Sasha7b9Work/IntelAvto/README.md

# IntelAvto

** Tools

- Keil uVision 5.42a
- ARM compiler 6.21
