Sasha7b9Work/IntelAvto/doc/РД/Images/readme.txt

Пребразовать *.zip в массив C++ :
    GUI-версия -> Инструменты -> Конвертировать
