Sasha7b9Work/IntelAvto/doc/Комплектация2.docx

пп | Наименование | Кол-во | Примечание
1 | Одноплатный компьютер Orange Pi 5 Plus 8GB | 1
2 | Сетевое зарядное устройство Ugreen CD275 | 1
3 | Кабель Ugreen US316 | 2 | Type-C, 1м
4 | Накопитель SSD KingSpec NE-128-2280 | 1
5 | Карта памяти Kingston Canvas Select Plus microSDXC 64GB | 2
6 | Мышь Logitech M170 Wireless | 1 | беспроводная
7 | Клавиатура SmartBuy One SBK-238AG-K | 1 | беспроводная
8 | Дисплей Zhixianda 12” 1024x768 | 1 | HDMI, сенсорный ёмкостный экран
9 | Cетевой адаптер GST36E12-P1J | 1
10 | Кабель Ugreen HD104 | 2 | HDMI, 0.5м
11 | Карт-ридер Ugreen CM185 | 1
