Sasha7b9Work/IntelAvto/doc/Комплектация.docx

Одноплатный компьютер

1. Orange Pi 5 Plus 4/8/16 GB RAM.

Пример - https://clck.ru/3JQ5TD

2. Cетевое зарядное устройство 220/5В, разъём Type-C, ток не менее 4А.

Пример - https://clck.ru/3JQ5gP

3. Кабель USB с разъёмами Type-C.

Пример - https://clck.ru/3JQ5wi

4. Твердотельный накопитель SSD 128 GB, форм-фактор M.2, размер 2280.

Пример - https://clck.ru/3JQE7P

Дислей

1. Дисплей 12 дюймов, разрешение 1024х768, интерфейс HDMI, ёмкостный сенсорный экран.

http://www.cnzhixianda.com/en/product_547073.html

Производитель/поставщик - Zhixianda - http://www.cnzhixianda.com/en/

Примеры:

https://clck.ru/3JQBTy

https://clck.ru/3JQBbk

https://clck.ru/3JQBnd

https://clck.ru/3JQByH

2. Сетевой адаптер 12В, 3А GST36E12-P1J

Пример - https://clck.ru/3JQQ2D

3. Кабель HDMI-MicroHDMI, 1м, производитель – Ugreen

https://clck.ru/3JQSKZ
