Sasha7b9Work/IntelAvto/doc/Hardware/IT6500/МНИПИ_IT6523C-испытания/Осциллограммы/006-DIN40839-12-T9-CVHI.png

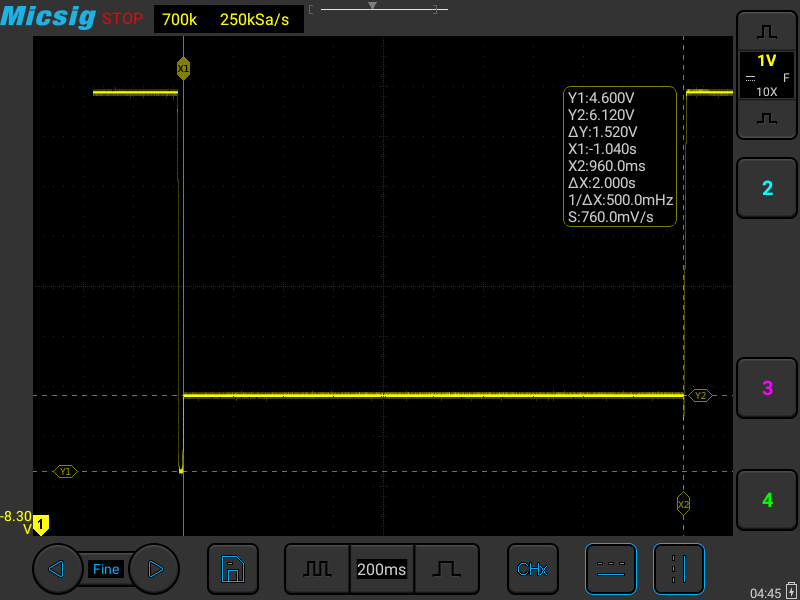
doc/Hardware/IT6500/МНИПИ_IT6523C-испытания/Осциллограммы/006-DIN40839-12-T9-CVHI.png
