Sasha7b9Work/IntelAvto/doc/Hardware/IT6500/МНИПИ_IT6523C-испытания/Осциллограммы/006-LDA-12-14V-80V.png

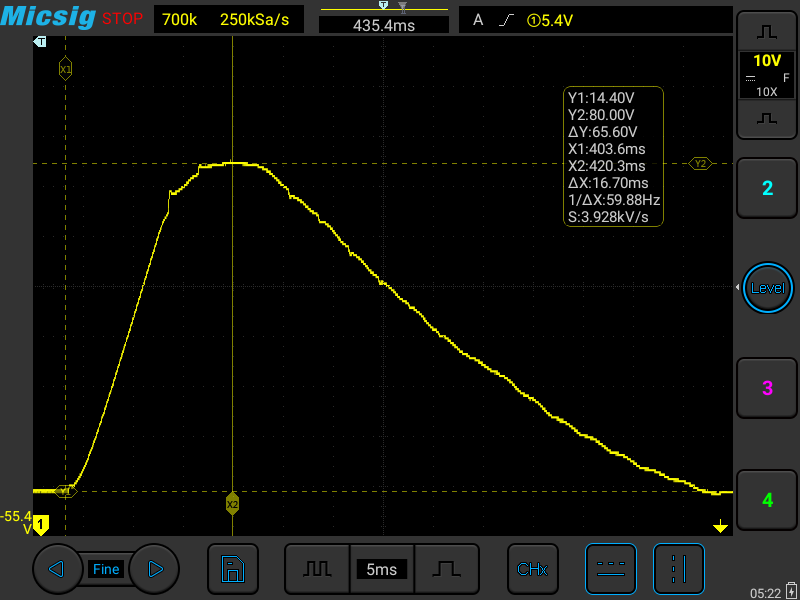
doc/Hardware/IT6500/МНИПИ_IT6523C-испытания/Осциллограммы/006-LDA-12-14V-80V.png
