Sasha7b9Work/IntelAvto/doc/Hardware/IT6500/МНИПИ_IT6523C-испытания/Осциллограммы/006-LDA-12-TD1479.png

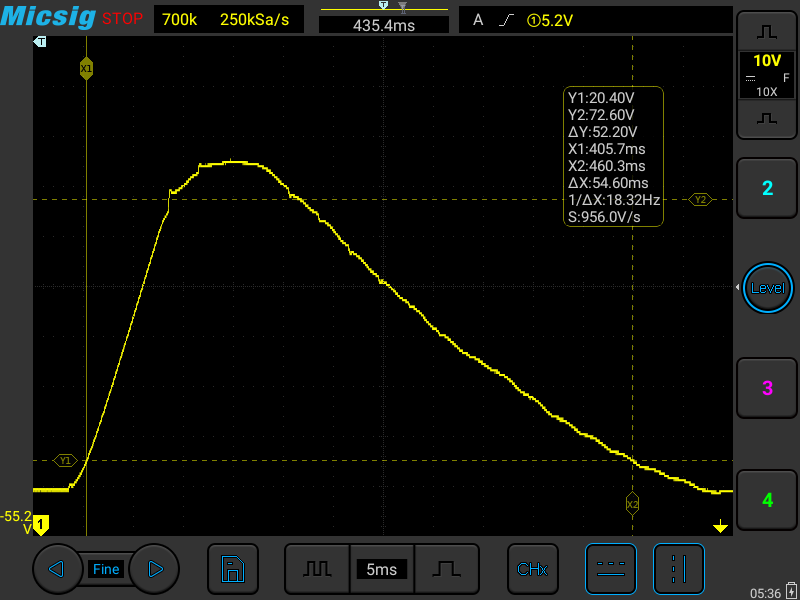
doc/Hardware/IT6500/МНИПИ_IT6523C-испытания/Осциллограммы/006-LDA-12-TD1479.png
