Sasha7b9Work/IntelAvto/doc/Hardware/IT6500/МНИПИ_IT6523C-испытания/Фото/IMG_4344.JPG

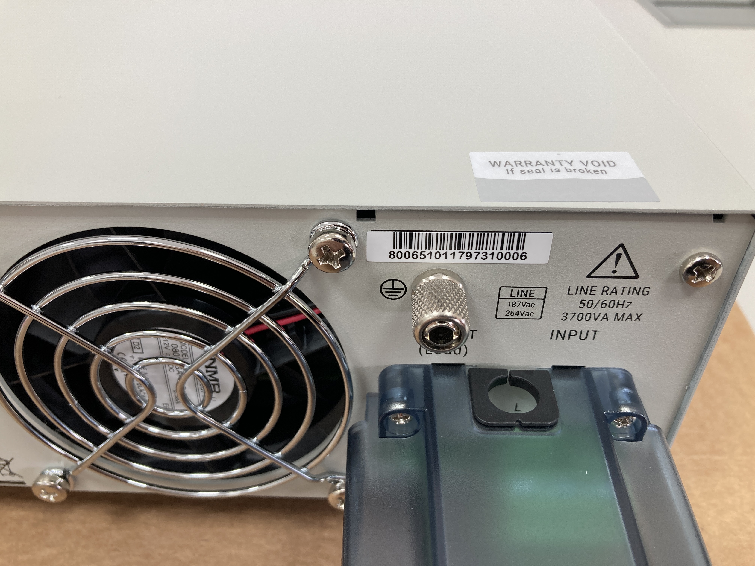
doc/Hardware/IT6500/МНИПИ_IT6523C-испытания/Фото/IMG_4344.JPG
