Sasha7b9Work/IntelAvto/doc/РД/Images/display.png

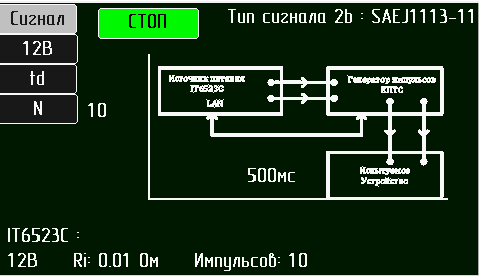
doc/РД/Images/display.png
