Sasha7b9Work/IntelAvto/doc/РД/Images/Signal1/Signal1.png

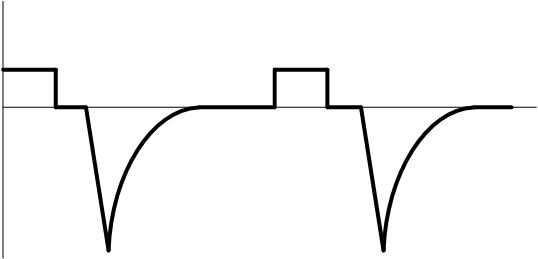
doc/РД/Images/Signal1/Signal1.png
