Sasha7b9Work/IntelAvto/doc/РД/Images/Signal2a/Signal2a.png

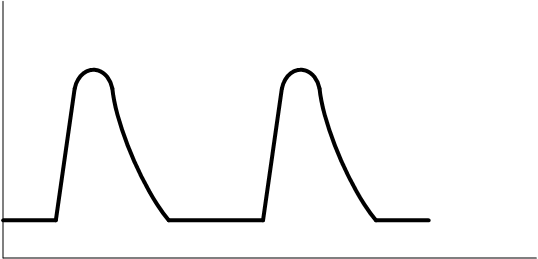
doc/РД/Images/Signal2a/Signal2a.png
