Sasha7b9Work/IntelAvto/doc/РД/Images/Signal2b/Signal2b.png

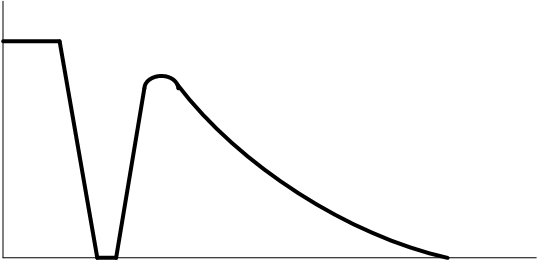
doc/РД/Images/Signal2b/Signal2b.png
