Sasha7b9Work/IntelAvto/doc/РД/Images/Signal3a/Signal3a.png

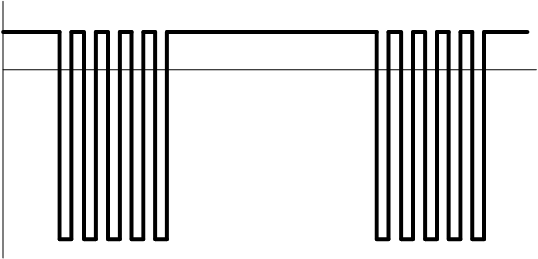
doc/РД/Images/Signal3a/Signal3a.png
