Sasha7b9Work/IntelAvto/doc/РД/Images/Signal3b/Signal3b.png

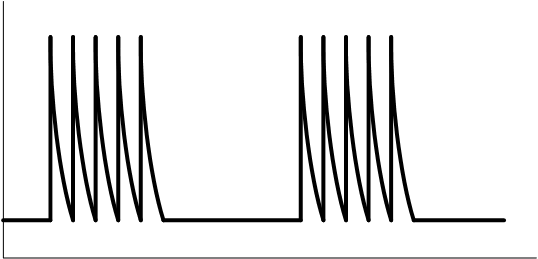
doc/РД/Images/Signal3b/Signal3b.png
