Sasha7b9Work/IntelAvto/doc/РД/Images/Signal4/Signal4.png

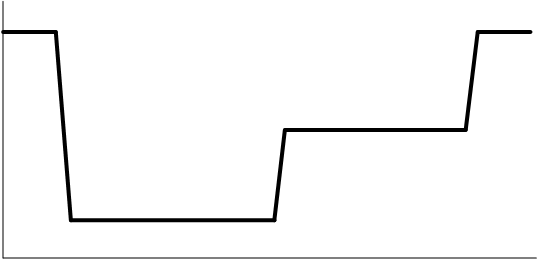
doc/РД/Images/Signal4/Signal4.png
