Sasha7b9Work/IntelAvto/doc/РД/Images/Signal5a/Signal5a.png

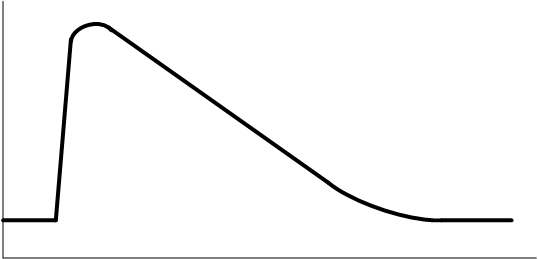
doc/РД/Images/Signal5a/Signal5a.png
