Sasha7b9Work/IntelAvto/doc/РД/schematic/SWD panel.jpg

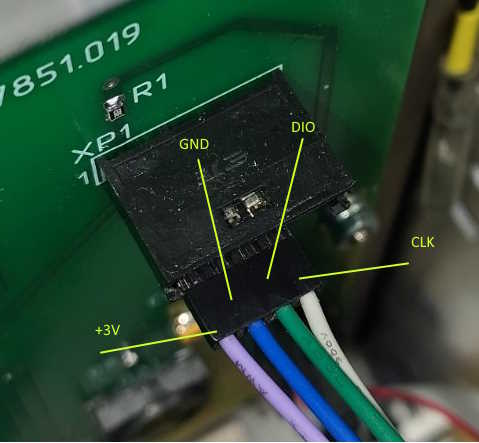
doc/РД/schematic/SWD panel.jpg
