Sasha7b9Work/IntelAvto/sources/Device/src/Hardware/HAL/HAL_PINS.cpp

// 2024/02/01 16:42:26 (c) Aleksandr Shevchenko e-mail : Sasha7b9@tut.by
#include "defines.h"
#include "Hardware/HAL/HAL.h"
#include "Hardware/HAL/HAL_PINS.h"
#include "Hardware/Timer.h"
#include <stm32f4xx_hal.h>


PinOut pin_A0_RG(GPIOG, GPIO_PIN_8);
PinOut pin_A1_RG(GPIOG, GPIO_PIN_7);
PinOut pin_A2_RG(GPIOG, GPIO_PIN_6);
PinOut pin_A3_RG(GPIOG, GPIO_PIN_5);
PinOut pin_CLK_RG(GPIOD, GPIO_PIN_11);
PinOut pin_DAT_RG(GPIOD, GPIO_PIN_13);
PinOut pin_WR_RG(GPIOD, GPIO_PIN_12);
PinOut pin_A12(GPIOE, GPIO_PIN_13);
PinOut pin_2A(GPIOE, GPIO_PIN_12);
PinOut pin_3AB(GPIOE, GPIO_PIN_11);
PinOut pin_K4_COM(GPIOC, GPIO_PIN_3);
PinOut pin_K5_COM(GPIOC, GPIO_PIN_2);
PinOut pin_K6_COM(GPIOC, GPIO_PIN_1);
PinOut pin_K7_COM(GPIOC, GPIO_PIN_0);
PinOut pin_K3_COM(GPIOF, GPIO_PIN_10);

PinOut pin_K1_FOR(GPIOF, GPIO_PIN_1);

PinOut pin_DAC_SCLK_R(GPIOA, GPIO_PIN_12);
PinOut pin_DAC_DAT_R(GPIOA, GPIO_PIN_11);
PinOut pin_DAC_ENB_HV(GPIOA, GPIO_PIN_8);
PinOut pin_DAC_CS(GPIOA, GPIO_PIN_10);

PinOut pin_ON_OFF(GPIOD, GPIO_PIN_9);
PinOut pin_START(GPIOD, GPIO_PIN_8);            // 77
PinOut pin_STOP(GPIOB, GPIO_PIN_15);
PinOut pin_NPULES0(GPIOG, GPIO_PIN_0);
PinOut pin_NPULSE1(GPIOF, GPIO_PIN_15);
PinOut pin_NPULSE2(GPIOF, GPIO_PIN_14);


void HAL_PINS::Init()
{
    pin_A0_RG.Init();
    pin_A1_RG.Init();
    pin_A2_RG.Init();
    pin_A3_RG.Init();
    pin_CLK_RG.Init();
    pin_DAT_RG.Init();
    pin_WR_RG.Init();

    pin_ON_OFF.Init();
    pin_START.Init();
    pin_STOP.Init();

    pin_A12.Init();
    pin_2A.Init();
    pin_3AB.Init();
    pin_K3_COM.Init();
    pin_K5_COM.Init();
    pin_K6_COM.Init();
    pin_K7_COM.Init();

    pin_K1_FOR.Init();

    pin_DAC_SCLK_R.Init();
    pin_DAC_DAT_R.Init();
    pin_DAC_ENB_HV.Init();
    pin_DAC_CS.Init();
    pin_DAC_CS.ToHi();

    pin_NPULES0.Init();
    pin_NPULES0.ToHi();
    pin_NPULSE1.Init();
    pin_NPULSE1.ToHi();
    pin_NPULSE2.Init();
    pin_NPULSE2.ToLow();
}


void PinOut::ToHi()
{
    GPIO_TypeDef *gpio = (GPIO_TypeDef *)port;

    HAL_GPIO_WritePin(gpio, pin, GPIO_PIN_SET);
}


void PinOut::ToHi(uint timeUS)
{
    ToHi();

    HAL_TIM::DelayUS(timeUS);

    ToLow();
}


void PinOut::ToLow()
{
    GPIO_TypeDef *gpio = (GPIO_TypeDef *)port;

    HAL_GPIO_WritePin(gpio, pin, GPIO_PIN_RESET);
}


void PinOut::ToState(bool state)
{
    state ? ToHi() : ToLow();
}


bool PinIn::IsLow() const
{
    return HAL_GPIO_ReadPin((GPIO_TypeDef *)port, pin) == GPIO_PIN_RESET;
}


bool PinIn::IsHi() const
{
    return !IsLow();
}


void Pin::Init()
{
    if (mode == PinMode::OUTPUT)
    {
        GPIO_InitTypeDef is =
        {
            pin,
            GPIO_MODE_OUTPUT_PP,
            GPIO_PULLUP
        };
        HAL_GPIO_Init((GPIO_TypeDef *)port, &is);

        HAL_GPIO_WritePin((GPIO_TypeDef *)port, pin, GPIO_PIN_RESET);
    }
    else if (mode == PinMode::INPUT)
    {
        GPIO_InitTypeDef is =
        {
            pin,
            GPIO_MODE_INPUT,
            GPIO_PULLUP
        };

        HAL_GPIO_Init((GPIO_TypeDef *)port, &is);
    }
}
