Sasha7b9Work/IntelAvto/sources/common/Display/Colors_.h

// (c) Aleksandr Shevchenko e-mail : Sasha7b9@tut.by
#pragma once
#include "defines.h"


struct Color
{
    static Color FILL;              // Цвет белых надписей
    static Color BACK;              // Цвет фона
    static Color MENU_UNSELECT;     // Фон невыделенного итема
    static Color MENU_SELECT;       // Фон выделенного итема
    static Color RED;               // Красный компонент для настройки
    static Color GREEN;             // Зелёный компонент для настройки
    static Color BLUE;              // Синий компонент для настройки
    static Color WHITE;             // Белый
    static Color BLACK;             // Чёрный фон
    static Color GRAY;
    static Color YELLOW;
    static Color GRAY_75;

    static const int COUNT = 255;

    explicit Color(uint8 i) : index(i) {}

    void SetAsCurrent() const;
    static Color GetCurrent();

    uint8 Index() const { return index;  }

    void SetValue(uint value) const { Value() = value; }
    void SetValue(uint8 red, uint8 green, uint8 blue) const { Value() = Make(red, green, blue); }

    // Ссылка на значение
    uint &Value() const;

    static uint Make(uint8 r, uint8 g, uint8 b) { return ((uint)((b) | ((g) << 8) | ((r) << 16))); }

    uint8 GetRED() const;
    uint8 GetGREEN() const;
    uint8 GetBLUE() const;

private:

    uint8 index;
};


struct ColorScheme
{
    static const int COUNT = 3;
    uint colors[Color::COUNT];

    static ColorScheme &Current();
};


namespace ColorTimer
{
    void Reset();
    bool IsMain();
}


#ifdef GUI

    #define MAKE_COLOR(r, g, b)     ((uint)((b) | ((g) << 8) | ((r) << 16)))

    #define RED_FROM_COLOR(color)   ((uint8)(((color) >> 16) & 0xFF))
    #define GREEN_FROM_COLOR(color) ((uint8)(((color) >> 8) & 0xFF))
    #define BLUE_FROM_COLOR(color)  ((uint8)((color) & 0xFF))
#else

    #define RED_FROM_COLOR(color)   ((uint8)(((color) >> 16) & 0xFF))
    #define GREEN_FROM_COLOR(color) ((uint8)(((color) >> 8) & 0xFF))
    #define BLUE_FROM_COLOR(color)  ((uint8)((color) & 0xFF))

#endif
