Sasha7b9Work/IntelAvto/sources/common/FlashDrive/FileManager.h

// 2025/02/03 14:33:10 (c) Aleksandr Shevchenko e-mail : Sasha7b9@tut.by
#pragma once 


namespace FileManager
{
    // Вызывается один раз при обнаружении новой флешки
    void Init();

    // Нарисовать файловый менеджер
    void Draw();

    void PressSB_LevelUp();

    void PressSB_LevelDown();

    void RotateRegSet(int angle);

    bool GetNameForNewFile(char name[255]);

    void PressSB_Tab();
};
