Sasha7b9Work/IntelAvto/sources/Device/src/Generator/MCP4811.h

// 2024/02/02 00:22:10 (c) Aleksandr Shevchenko e-mail : Sasha7b9@tut.by
#pragma once


struct Value;


// Определяет размах выходного напряжения
namespace MCP4811
{
    void SetVoltage(const Value &);

    void Disable();
}
