Sasha7b9Work/IntelAvto/sources/Device/src/Connector/Device/Interface_d.h

// (c) Aleksandr Shevchenko e-mail : Sasha7b9@tut.by
#pragma once
#include "Utils/Queue_.h"


namespace DInterface
{
    void Update();

    // Возвращает ссылку на очередь сообщений, ожидающих отправки
    Queue &GetOutbox();
};
