Sasha7b9Work/IntelAvto/sources/Device/src/Generator/MAX532.h

// 2024/02/04 18:33:29 (c) Aleksandr Shevchenko e-mail : Sasha7b9@tut.by
#pragma once


struct Value;


// Источник питания истокового повторителя
namespace MAX532
{
    void SetVoltage(const Value &);

    void Test();
}
