Sasha7b9Work/IntelAvto/sources/common/Connector/Transceiver_.h

// (c) Aleksandr Shevchenko e-mail : Sasha7b9@tut.by
#pragma once
#include "Connector/Messages_.h"


/*

    Передача должна производиться так.

*/


namespace Transceiver
{
    void Transmit(BaseMessage *message);
};
