Sasha7b9Work/IntelAvto/sources/common/Display/Symbols_.h

// (c) Aleksandr Shevchenko e-mail : Sasha7b9@tut.by
#pragma once


#define SYMBOL_AC                  0x80
#define SYMBOL_AC_IN_QUOTES       "\x80"
#define SYMBOL_DC                  0x81
#define SYMBOL_DC_IN_QUOTES       "\x81"
#define SYMBOL_FRONT               0x82     // Фронт
#define SYMBOL_FRONT_IN_QUOTES    "\x82"
#define SYMBOL_RISE                0x83     // Срез
#define SYMBOL_RISE_IN_QUOTES     "\x83"


struct UGO
{
    static pchar OVERLAPPED;    // Индикация переполнения
    static pchar EMPTY_VALUE;   // Выводится, когда значение ещё не получено после засылки значения
    static pchar DivNULL;       // Индикация деления на ноль
};
