Sasha7b9Work/IntelAvto/sources/VS/Panel/src/GUI/ConsoleSCPI.h

// 2023/09/08 21:00:21 (c) Aleksandr Shevchenko e-mail : Sasha7b9@tut.by
#pragma once
#pragma warning(push, 0)
#include <wx/frame.h>
#include <wx/timer.h>
#pragma warning(pop)


class ConsoleSCPI : public wxFrame
{
public:

    static pString DIRECT_PROMT;
    static pString REVERSE_PROMT;

    static ConsoleSCPI *Self();
    virtual ~ConsoleSCPI();

    void SwitchVisibility();

    void AddLine(const wxString &);
    void AddText(const wxString &);
    void AddTextPromt(const wxString &);

    void StartTest();
    void StopTest();

private:
    ConsoleSCPI(wxFrame *parent);

    void OnSize(wxSizeEvent &);
    void OnTextEnter(wxCommandEvent &);
    void OnTextControlKeyDown(wxKeyEvent &);
    void OnClose(wxCloseEvent &);

    wxTimer timerComPort;
    wxTimer timerTest;
    void OnTimerComPort(wxTimerEvent &);
    void OnTimerTest(wxTimerEvent &);

    void SendToSCPI(const char *);

    class History
    {
    public:
        void Add(const wxString &text);
        wxString Next();
        wxString Prev();

    private:
        std::vector<wxString> history;
        uint position = 1;
    };

    History history;
};
