Sasha7b9Work/IntelAvto/(commit log)

2023-09-08 GUI-версия компилируется, но не работает
2023-09-08 Работает GUI-версия
2023-09-11 Запускается на макете частотомера
2023-11-02 Работает на макете
2023-11-02 Исправлены баги отображения на приборе
    [Display_stm.cpp]
2023-11-02 сигнал 3a
2023-11-02 сигнал 3b
2023-11-02 сигнал 4
2023-11-02 Начало сигнала 5а
2023-12-13 Процессор изменили на 429. Не компилируется
2023-12-14 Компилируется Panel
2023-12-14 vs_keil компилируется
2023-12-14 Всё компилируется
2023-12-14 Готово к пробной записи
2023-12-14 Запускается, но где-то висит
2023-12-14 оптимизинованы засылки в дисплей
2023-12-14 Рвботает
2023-12-18 keil компилируется без предупреждений после перехода на C++ 6
2023-12-18 keil часть предупреждений удалены
2023-12-18 Компилируется release-версия Panel keil
2023-12-18 Компилируются release- и debug-версии Panel keil
2023-12-18 Компилируется loader - release
2023-12-18 Всё keil компилируется без предупреждений
2023-12-18 Loader отделён от Panel
2023-12-19 Компилируется win-версия
2023-12-19 Не компилируется
2023-12-20 Вылет при запуске win-версии
2023-12-20 Восстановлена работоспособность win
2024-01-18 Не работает
2024-01-25 Восстановлена компилируемость vs_keil-версии
2024-02-01 Исправлен баг с вылетом на последнем сигнале
2024-02-01 v2 Напряжение вводится в вольтах, время - в миллисекундах
2024-02-01 v3 Начинаем Device в Panel
2024-02-01 v4 Заготовка для информации о генерации импульсов
2024-02-01 Добавлены файлы от Г6-49 для Device - там такой же процессор и интерфейс SPI для сообщения
2024-02-01 Не компилируется Device
2024-02-01 Компилиуется Device. Без функционала
2024-02-04 реле платы коммутации установленаы
2024-02-05 В панель докинуты файлы для SPI с платой управления
2024-02-05 Инициализирован SPI на стороне панели
2024-02-05 Добавлен файл SPI в Device
2024-02-08 С оптимизацией не работает. Наверное, дело в скорости засылки
2024-02-08 Частично работает клавиатура не вводится значение и не работает кнопка ручки
2024-02-08 Работает на оптимизации О1
2024-02-08 Работает на оптимизации fast
2024-02-08 Оптимизация дисплея закончена
2024-02-08 Работает управление кроме кнопки ручки
2024-02-08 Настроены отладчики
2024-02-08 Работает чипселект на SPI
2024-02-08 Пошёл сигнал на устройство
2024-02-08 Плата принимает переданную информацию
2024-02-08 В теории команда должна доходить до прибора
2024-02-08 Идёт команда Start2A на отработку
2024-02-08 устройство принимает, но только в отладке
2024-02-08 Приём в Device сделан программно
2024-02-08 Не работает программный SPI
2024-02-08 Теоретически реализовван программный SPI@
2024-02-09 Работает программный SPI в обе стороны
2024-02-09 Без отладчика не работае
2024-02-12 Уменьшено время сообщения между платами до 1 мс
2024-02-12 Работает передача
2024-02-12 Уменьшена длительность передачи
2024-02-12 По нажатию кнопки ПУСК идёт команда
2024-02-12 Не работает установка периода
2024-02-12 Не работает установка период
2024-02-12 Засылается период сигнала 2А
2024-02-13 Начинаем переходить на другое представление единиц измерений
2024-02-14 Работает ввод временных параметров
2024-02-14 Установка на экране параметров первого сигнала
2024-02-15 не работают сигналы
2024-02-15 Кажется, работает
2024-02-20 Тест MAX532
2024-02-27 Первая версия засылки напряжения
2024-02-27 Вторая версия засылки напряжения
2024-02-27 Подогнаны пределы MAX532@
2024-08-21 Без задержки не работал чипселект. Оставил пометку
2025-01-15 Переделана клавиатура под текущую, но вообще не работает
2025-01-15 Отмотали на две версии назад
2025-01-15 Возврат на keil 5.37
2025-01-15 Работает на 5.37
2025-01-15 Работает 5.39Э
2025-01-15 Не работаеь на 5.40
2025-01-16 Переход на Keil 5.39
2025-01-16 Удалён английский язык
2025-01-16 Добавлен переключатель для 12/24V
2025-01-16 Добавлены кнопки 12/24V на все страницы
2025-01-16 У релизной сборки панели fast-оптимизация
2025-01-17 Компилируется
2025-01-17 В процессе переназначения выводов
2025-01-17 Установлены значения по умолчанию при включении
2025-01-20 Работают кнопки правильно
2025-01-20 Правильно отображаются отрицательные значения
2025-01-20 Работает ввод напряжения на первом сигнале с ограничениями
2025-01-20 Кнопка 5 теперь работает
2025-01-20 Передаются команды старт, пауза, продолжить, стоп
2025-01-20 Исправлено отображение цветов
2025-01-21 Добавлен чип-селект для MCP4811
2025-01-21 Работает установка высокого напряжения
2025-01-22 Исправлены управления FPGA в Devcie
    [FPGA.cpp, HAL_PINS.cpp]
2025-01-22 Компилируется GUI-версия
2025-01-22 Сигналы NPULSE вёрнуты на предыдущие контакты2
2025-01-22 Тестовый проект
2025-01-23 Восстановлена работоспособность после тестовой версии
2025-01-24 Восстановлен pin ON OFF
2025-01-27 На экране задаются параметры импульсов, формируемых самостоятельно
2025-01-27 Начальные значения соответствуют ТЗ
2025-01-28 Исправлен баг, когда цвет кнопки СТОП менялся без причины
    [FPGA.cpp, FPGA.h, Generator.cpp, HAL_PINS.cpp, Timer.cpp]
2025-01-28 Добавлены исходники uzlib
2025-01-28 Делаем преобразования zip-файла в массив. Не компилируется
2025-01-28 Пишется файл .cpp
2025-01-29 Добавлена заготовка для отрисовки архивированных картинок
2025-01-29 Добавлена библиотека miniz
2025-01-29 Декомпрессия сделана. Не проверена
2025-01-29 Читает информацию о файлеЭ
2025-01-29 В дебаге выводит картинку. Пробуем заработать в релизе
2025-01-29 Выводит рисунок в release
2025-01-29 Теперь память освобождается после отрисовки картинки
2025-01-29 Ускорен вывод на дисплей
2025-01-29 Ускорена отрисовка картинки - точки цвета фона не рисуются
2025-01-29 Поключён sct-файл Для панели
2025-01-29 Рисунок хранится в CCM
2025-01-29 Теперь рисунок распаковывается только один раз, пока не нужно отрисовывать другой
2025-01-30 Работает gui-проект
2025-01-30 Скорректировано положение параметров сигнала 1 на экране
2025-01-30 'Не прошивается прошивка
2025-01-30 Восстановлена работоспособность прошивки
2025-01-30 Вольты отображаются русскими буквами
2025-01-31 Файлы библиотеки CubeF4 обновлены до 28.1
2025-01-31 Компилируемость восстановлена
2025-01-31 Миллисекунды теперь не выводятся
2025-01-31 Исправлен баг неустановки первого значения
    [Messages_.h, defines.h]
2025-01-31 Перестала работать связь между платами
2025-01-31 Откат на две версии назад, когда всё работало
2025-02-03 Все версии компилируются
2025-02-03 Работает vs_win@
2025-02-03 Работает заготовка выхода в главное меню
2025-02-03 Комплируется vs_keil кроме FontBig.cpp
2025-02-03 Компилируется Panel-release после добавления флешки (не проверялось)
2025-02-04 Все версии собираются и работают
2025-02-04 Работает после добавления системы USBH
2025-02-04 Не компилируется после добавления LwIP
2025-02-04 Собирается Keil
2025-02-04 Не получилось подключить LAN
2025-02-04 Возврат к версии от 2025:02:04 9:17
2025-02-05 По крайней мере не висит на флешке
2025-02-05 Подключаем VCP. Не компиилируется
2025-02-11 Компилируется после добавления VCP
2025-02-11 Исправлен баг в Math::ItoA
    [defines.h]
2025-02-11 Исправлен баг с ненажатием кнопки СТАРТ
    [defines.h]
2025-02-11 Добавлено время для всех наших сигналов
2025-02-11 Добавлена кнопка ИНФОРМАЦИЯ
2025-02-11 Увеличена ширина кнопок меню в несигнальных страницах
2025-02-11 Добавлено ограничение на напряжение в Device
2025-02-11 Добавлена страница информации
2025-02-11 Восстановлена работоспособность ручки в GUI
2025-02-11 Управлять сопротивлением нагрузки для сигнала 1 не будем
2025-02-11 Подключены файлы от звука С8-54
2025-02-11 Вроде исправлен баг незапуска на кнопке 12В
    [defines.h]
2025-02-11 keil компилируется без ошибок
2025-02-11 Кажется, всё что нужно для звука подключено
2025-02-13 Исправлено вращение ручки вверх на коррекциии значения параметра
    [defines.h]
2025-02-13 Исправлен баг в клавиатуре. Убраны длинные нажатия
    [Keyboard_.cpp, defines.h]
2025-02-17 Переход на ветку Param_draw_struct
2025-02-17 Кажется, работает установка значения параметра ручкой
2025-02-18 Исправлена ошибка определения версии компилятора
    [defines.h]
2025-02-18 keil компилируется с предупреждениями
2025-02-18 keil всё собирается без предупреждений
2025-02-18 Компилируется vs_keil
2025-02-19 Пофикшена ошибка нерабочей прошивки после подключения LAN - она заключалась в вызове функции printf
2025-02-19 Работает тестовая страница на 192.168.1.200Э
2025-02-19 Работает соединение сокет на порту 7
2025-02-20 Не работает подключение к серверу
2025-02-20 Вызывается каллбэк на подключение к удалённому серверу
2025-02-20 refact. К серверу подключается
2025-02-20 Работает сервер на порту 7
2025-02-20 Работает засылка строки в серевер
2025-02-20 Работает многократное подключение/отключение
2025-02-20 удалённый сервер не принимает первую посылку
2025-02-20 прошивка успешно делает бесконечные попытки подключения к удалённому серверу
2025-02-20 Улучшен пинг
2025-02-21 Индикация подлкючения к серверу
2025-02-21 Делаем меню
2025-02-25 Не работает кнопка установки порта
2025-02-25 Работает кнопка установки порта
2025-02-27 IT6523 принимает System:remote
2025-02-27 Добавлено окно ввода MAC
2025-03-04 Определяется отключение сетевого кабеля
2025-03-11 Готовы к первому сигналу
2025-03-12 Условно работает 2b
2025-03-12 ГУИ отрабатывает остановку 2b
2025-03-12 сигнал 2b обрабатывает 12/24 вольта
2025-03-12 Отрисовывает количество оставшихся импульсов
2025-03-12 Устанавливается длительность для 2b@
2025-03-12 ИСправлен баг в переводе длительности в секунды
    [defines.h]
2025-03-12 Увеличено время дисконнекта от физической линии до 5 секунд
2025-03-12 Все сигналы отрабатывают на источнике с зафиксированными параметрами
2025-03-12 В сигнале 5b не устанавливается амплитуда. Длительность изменяется
2025-03-17 Заданы границы установки параметров для сигнала 4
2025-03-19 Начинаем USBD
2025-03-20 Компилируется USBD
2025-03-20 Глючит изображение на экране после добавления VCP. VCP тоже не работает
2025-03-20 Не проходит инициализация аппаратной части USBD
2025-03-20 Флешка не работает
2025-03-25 Не работает VCP
2025-03-25 Добавлена страница калибровки
2025-03-25 Добавлен тип аккумулятора в калибровку
2025-03-31 Отключили флешку и VCP
2025-03-31 Оставили одну точку
2025-03-31 Работает сохранение настроек
2025-03-31 Калибровочные настройки добавлены в общие
2025-03-31 Подбираемся к калибровке
2025-03-31 Работает индикация подачи на выход напряжения при калибровке
2025-04-07 Сброс дисплея каждые 30 сек
2025-04-08 Задействована кнопка ручки
2025-04-08 Название
2025-04-09 Добавлена кнопка сброса дисплея
2025-04-09 Подправлены импульсы 5а, 5б
2025-04-10 Сделана установка сопротивления для импульсов 5
2025-04-11 Начинаем переход на милливольты в Voltage
2025-04-14 Исправлен баг сигнала 4 - амлитуды были поменяны местами
    [defines.h]
2025-04-16 теперь из поля ввода напряжения при калибровке извлекаются милливольты, а не вольты, как ранее
2025-04-17 Продалжаем делать калибровку
2025-04-17 Изменение в коммутациях реле Device
2025-04-17 КАЖЕТСЯ, закончена калибровка
2025-04-18 Калибровка работает
2025-04-23 Исправлен расчёт напряжения
2025-04-25 Исправлены максимальные значения на сигналах 3а, 3б
    [MCP4811.cpp, defines.h]
2025-04-29 wxWidgets обновлено до 3.2.8Э
2025-04-29 Теперь рассчитанное значение выводится только для соответствующих сигналов
2025-04-30 Добавлено изображение сигнала 3а
2025-04-30 Добавлено изображение сигнала 3b
2025-04-30 Добавлено изображение сигнала 4
2025-05-02 Добавлены изображения сигналов 5а, 5b
2025-05-02 Пытаемся завести флешку. Не получается
2025-05-06 Половина резета USB прошло, но на второй половине виснет
2025-05-08 Срабатывает прерывание от флешки OTF HS
2025-05-12 Работает прерывание от флешки
2025-05-12 Готовимся к подключению флешки на vs_win
2025-05-12 Теперь кнопка ФЛЕШКА неактивна, если флешка не поюключена
2025-05-13 В исходный код добавлен контроль версии компилятора
2025-05-13 Не получается подключиться к флешке
2025-05-13 Удалено LAN. Не работает на 6.23
2025-05-13 Удалено VCP. Не работает на 6.23
2025-05-13 Удалено USBD. Не работает на 6.23
2025-05-13 Удалено FDrive, USBH, LwIP, fats. Не работает на 6.23
2025-05-13 Удалено minimz. Не работает на 6.23
2025-05-13 Удалено SCPI. Не работает на 6.23
2025-05-13 Удалено Display/Picture. Не работает на 6.23
2025-05-13 Удалено Keyboard. Не работает на 6.23
2025-05-13 После удаления меню заработало на 6.23
2025-05-13 Вёрнуто к состоянию до всех удалений
2025-05-13 Удалено PageSettings.cpp. Не работает на 6.23
2025-05-13 Удалено DEF_BUTTON. Не работает на 6.23
2025-05-13 Удалено DEF_CHOICE_2. Не работает на 6.23
2025-05-13 Удалено DEF_CHOICE_1_FULL
2025-05-13 Удалено DEF_CHOICE_2_FULL. Не работает на 6.23
2025-05-13 Удалено DEF_CHOICE_4_FULL. Не работает на 6.23
2025-05-13 Удалено PageCalibration.cpp. Не работает на 6.23
2025-05-13 Удалено PageLAN, Info, Signal1. Не работает на 6.23
2025-05-13 Удалены все страницы сигналов. Не работает на 6.23
2025-05-13 Удалено InputField. Не работает на 6.23
2025-05-13 Удалено PageMain. Не работает на 6.23
2025-05-13 Удалено ParameterDrawStruct. Не работает на 6.23
2025-05-13 Удалено MenuItems. Не работает на 6.23
2025-05-13 Удалено Menu. Не работает на 6.23
2025-05-13 Удалено Display/Painter. Не работает на 6.23
2025-05-13 Удалено Display. Работает на 6.23
2025-05-13 Добавлено предупреждение на компилятор не 6.23
2025-05-14 Возврат на компилятор 6.21
2025-05-14 Теперь и надписи появились
2025-05-14 заменили USBH. Не компилируется
2025-05-14 Компилируется, но флешка продолжает не работать
2025-05-15 Добавлен рабочий пример USB flash из Cube F4 1.28.1
2025-05-15 Обновлено F4 до 1.27.1
2025-05-15 Не запускается на новой версии
2025-05-15 Обновлён Cube F4 до текущей версии. Пример USB работает, а Panel не запускается
2025-05-15 Комплируется на 6.21 Keil 5.39
2025-05-19 Работает панель после экспериментов с разными компиляторами
2025-05-19 Не работал старт с link time optimization
2025-05-20 Вёрнуто к состоянию 2025-05-15 12:29. После обновления CubeF4 доя 1.27.1 не подключалось к источнику
2025-05-20 Единицы (сопротивление, N) теперь нормально вводятся
2025-05-21 Пикалка работает
2025-05-21 Компилируется vs_win
2025-05-21 Будем пробовать подключаться к VCP
2025-05-22 Отрабатываем прерывание FS от ком-порта, но ком-порт не определяется компьютером
2025-05-22 ПК видит VCP
2025-05-22 Вёрнуто к состоянию 2025-05-22-10-11
2025-05-22 Подключается ПК к VCP
2025-05-22 Управляем амплитудой на сигналах 5а, 5б
2025-05-23 Опять запускается vs_win
2025-05-23 Добавлена задержка микросекунд в GUI-версию
2025-05-23 Флешка присоединяется, только очень долго
2025-05-23 Возвращаемся к предыдущему коммиту - не работает связь с источником по LAN
2025-05-23 Добавлены файлы библиотеки ffmpeg
2025-05-26 Попытка исправить невозможность установки длительности t9 больше 10 сек
    [defines.h]
2025-05-26 Исправлен баг с плохим вводом дробных значений
    [defines.h]
2025-05-26 Работают длительности t9 более 10 секунд в четвёртом сигнале
2025-05-26 Убрано лишнее из настройки 4-го сигнала
2025-05-26 Исправлены две ошибки в командах на сигнале 4
    [defines.h]
2025-05-27 Кажется, разобрались с последовательностью выключения
2025-05-27 Для сигналов 5 24 В нижний предел диапазонов увеличен до 151 В
2025-05-28 refact. Перекинуты файлы USBH, USBD в другие места
2025-05-28 Заготовка для SCPI
2025-05-28 Добавлена команда SCPI. Все версии компилируются. Не проверялось
2025-05-28 Универсализирован вывод на дисплей в ГУИ-версии с прошивкой
2025-05-28 Надпись ТЕСТИРОВАНИЕ
2025-05-28 Подразобрались с длительностями испытаний
2025-05-28 Исправлено измерение длительности в импульсах 3a, 3b
    [defines.h]
2025-05-29 Скорректировано отображение надписи ТЕСТИРОВАНИЕ
2025-05-29 Компилируется загрузчик после переноса файлов из C8-57. Не проверялось
2025-05-29 Исправлена калибровка
2025-05-29 Расширен диапазон допустимых значений для генератора
2025-05-29 Не работает загрузчик
2025-05-30 Отказ от загрузчика. Панель запускается со стандартного адреса
2025-05-30 Кажется, глюк выделения параметров при возврате из меню убран
2025-05-30 Настройка отключения индикации засылаемого напряжения
2025-05-30 Сообщение о подключенной флешке
2025-05-30 Добавлена индикация времени в индикацию о подключении флешки
2025-05-30 Ускорено определение флешки
2025-05-30 Увеличена скорость засылки в дисплей
2025-05-30 Сохраняется тестовая картинка на флешку
2025-05-30 Картинка сохраняется
2025-05-30 Закончено с сохранением картинки на флешку
2025-05-30 win-версия работает
2025-06-24 Есть параметр ограничения тока на первом сигнале
2025-06-24 Есть на странице 2а
2025-06-24 Теперь параметр ПРЕДЕЛЬНЫЙ ТОК есть на всех сигналах
2025-06-24 Теперь у тока единицы измерения А
2025-06-24 Первая версия засылки тока
2025-06-24 Сделано выключение
2025-06-24 Напряжения увеличены до 13, 27
2025-06-25 Изображение флешки
2025-06-25 Кажется, сделана флешка
2025-08-17 Готовимся к рисункам схем включения
2025-08-17 Подключили рисунки схем
2025-08-18 Исправлена отрисовка картинок
2025-08-18 Восстановлены рисунки
2025-08-18 Подправлен вход в режим редактирования
2025-08-19 Работает SCPI в эмуляторе
2025-08-19 Делаем SCPI:
2025-08-25 Проверочная версия
2025-08-25 Реализована команда Signal:set
2025-08-25 Реализована команда signal:get?
2025-08-25 Реализована команда mode set get
2025-08-25 Заготовка для отображения схемы подключения
2025-08-26 Начинаем универсальный расчёт координат параметров
2025-08-26 Удалены неиспользуемые картинки
2025-08-28 Улучшено определение сети. Но теперь не определяется её отключение
2025-08-28 Отмена переделки
2025-08-28 Новый алгоритм определения подключения
2025-08-29 Исправлен новый алгоритм подключения. Предварительная финальная версия
    [defines.h, main.cpp]
2025-08-29 Пробуем исправить зависание при подключенном кабеле
    [HAL_IT.cpp, defines.h]
2025-08-29 В ClientTCP также исправлено
    [defines.h]
2025-09-15 Уменьшена ширина окна корректируемого значения
2025-09-15 Теперь окно выбранного значения заливается фоном не только во время коррекции
2025-09-22 Исправлен баг с неправильным набором значений IP-адреса
    [Keyboard_.cpp, defines.h]
2025-09-22 Делаем настройки param:us
2025-09-22 Продолжаем делать настройку param:us
2025-11-14 файлы wxWidgets обновлены до 3.3.1Э
2025-11-14 Собирается win-версия на wxWidgets 3.3.1
2025-11-20 Не работает кросс-кабель на втором экземпляре. Через switch работает
2025-11-21 Переход на Visual Studio 2026
2025-11-24 Добавлена принудительная установка в 100 МГц
2025-11-24 Отменено предыдущее изменение
2025-11-24 Восстановлена работоспособность win-версии
2025-11-24 Сделан SCPI на LAN
