Sasha7b9Work/IntelAvto/(notices)

Notices in the files:
sources/VS/Saver/src/GUI/rs232.c:
This program is free software: you can redistribute it and/or modify
it under the terms of the GNU General Public License as published by
the Free Software Foundation, either version 3 of the License, or
(at your option) any later version.
